bt-trx/dev-board/images/teensy_usb_cut.png

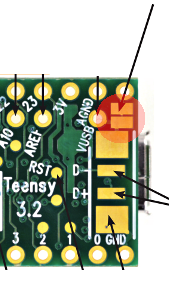
images/teensy_usb_cut.png
