bt-trx/dev-board/README.md

# bt-trx-dev-board

## BOM Generation

https://github.com/SchrodingersGat/KiBoM

### Installation

"Tools" -> "Generate Bill of Materials" -> New Plugin

### Benutzung

Eintragen der Bestellnummern ueber Properties des einzelnen Bauteils, oder gesammelt ueber "Tools"->"Edit Symbol Fields..."
