bt-trx/dev-board/images/3d_view.png

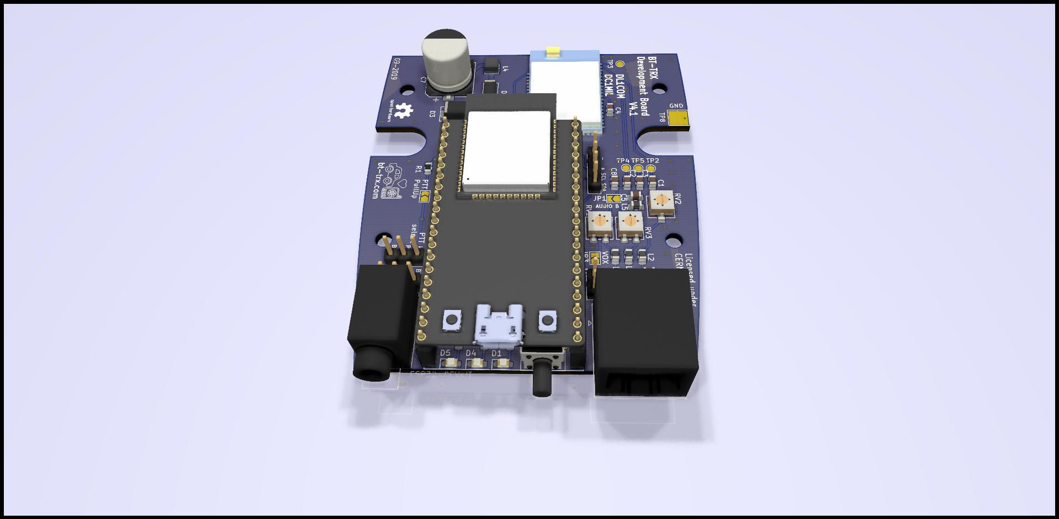
images/3d_view.png
