bt-trx/dev-board/3d_models/panasonic/EVQPU-LC-02K.STEP

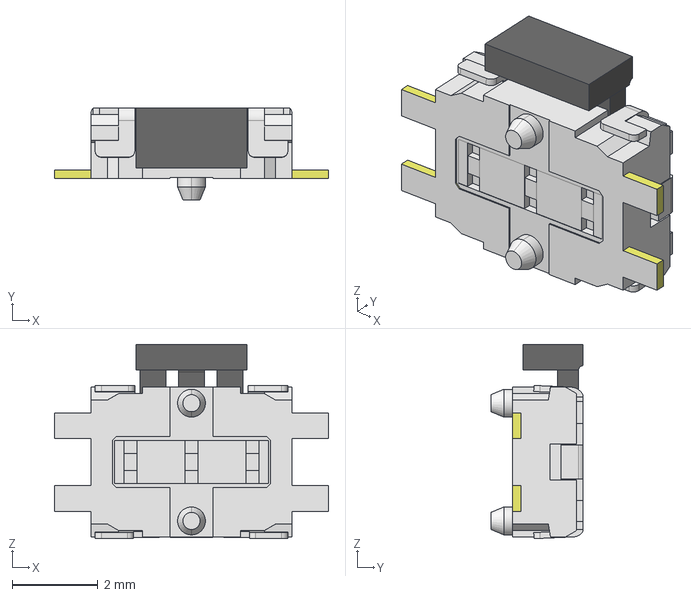
[picture p3: CAD file, 2019-08-11]
3d_models/panasonic/EVQPU-LC-02K.STEP
6.40 x 2.15 x 4.54 mm
