bt-trx/dev-board/3d_models/SJ1-3533NG/SJ1-3533NG.step

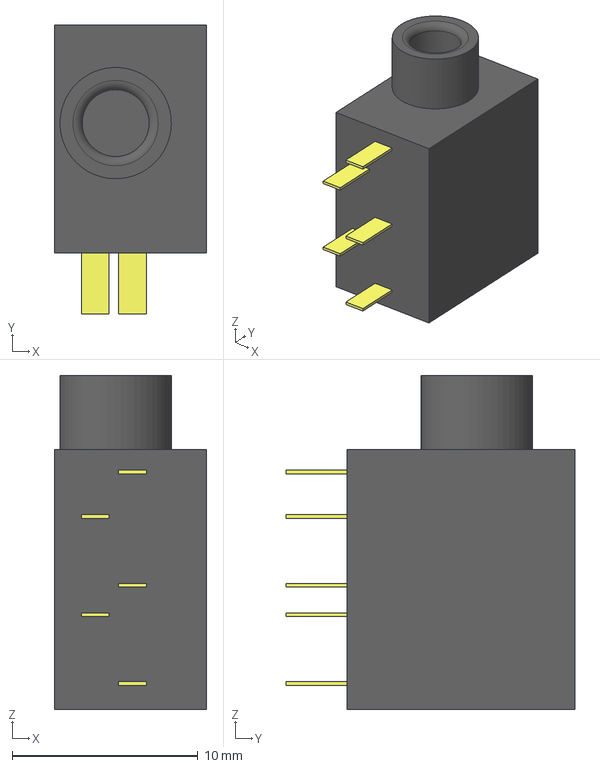
[picture p4: CAD file, 2019-08-11]
3d_models/SJ1-3533NG/SJ1-3533NG.step
8.20 x 15.6 x 18.0 mm
