bt-trx/dev-board/3d_models/54602-908LF/54602-908LF.step

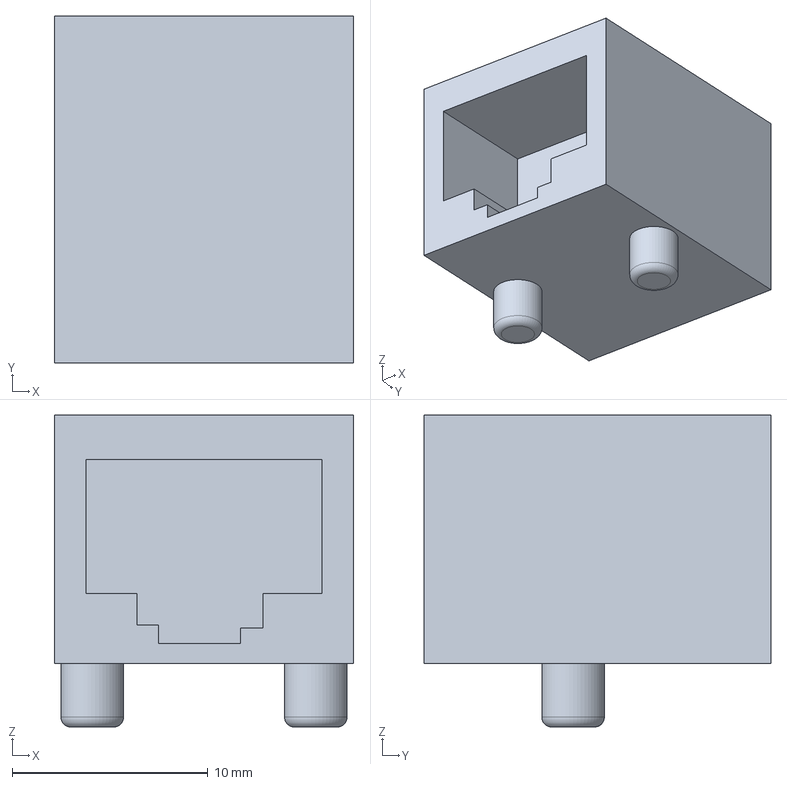
[picture p5: CAD file, 2019-08-11]
3d_models/54602-908LF/54602-908LF.step
15.3 x 17.7 x 16.0 mm
