bt-trx/dev-board/bt-trx-dev-board.kicad_pcb

## KiCad design bt-trx-dev-board.kicad_pcb (2020-01-25)

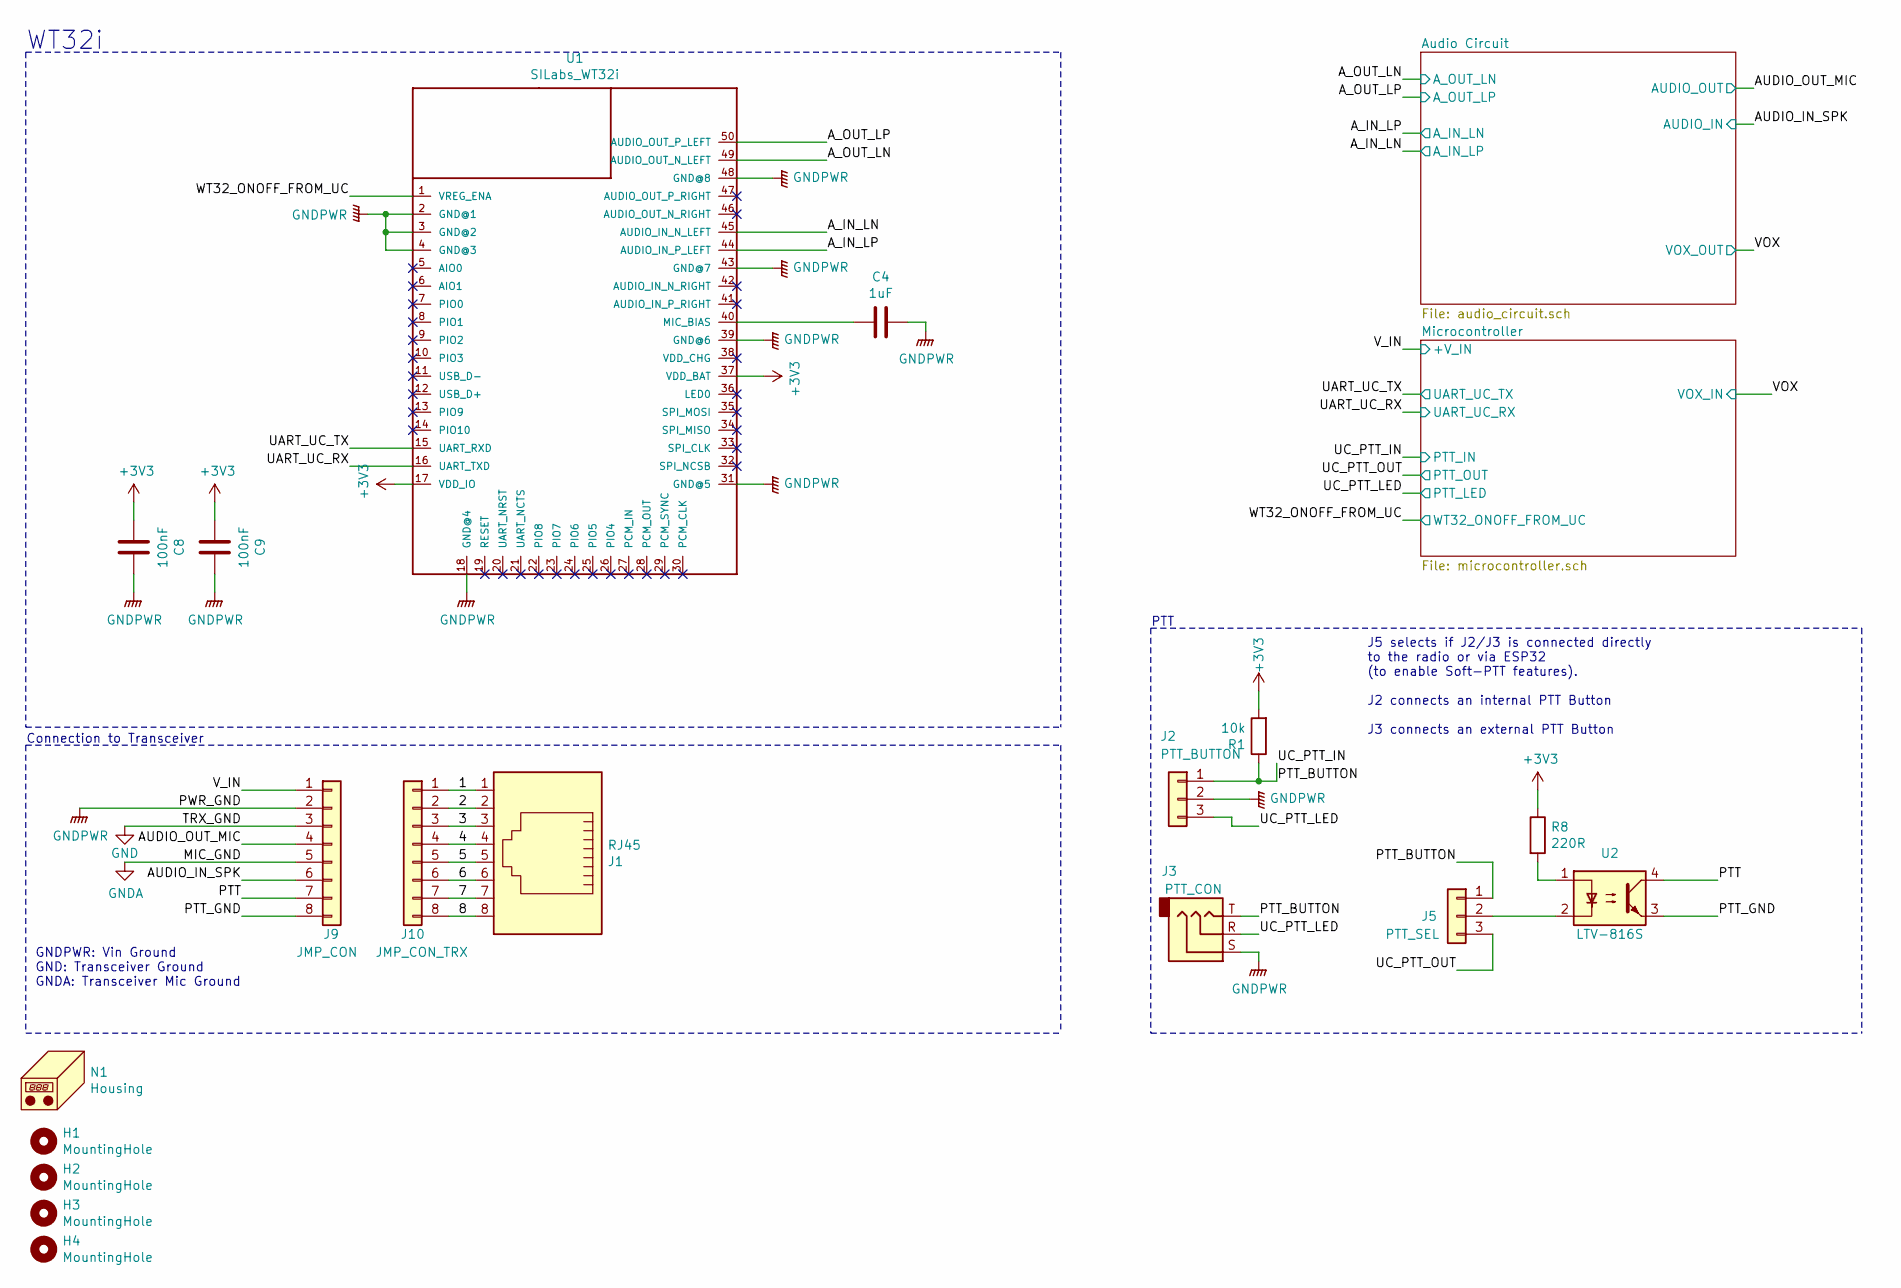
[picture p6: schematic bt-trx-dev-board.sch, BT-TRX Development Board]

Parts:
C4: 1uF; C_0805_2012Metric_Pad1.15x1.40mm_HandSolder; Mouser Best.Nr. 80-C0805C105K3RAUTO
C8, C9: 100nF; C_0805_2012Metric_Pad1.15x1.40mm_HandSolder; Mouser Best.Nr. 80-C0805C105K3RAUTO
H1, H2, H3, H4: MountingHole; MountingHole_3.2mm_M3_DIN965
J1: RJ45; RJ45_Amphenol_54602-x08_Horizontal; Mouser Best.Nr. 649-54602-908LF
J2: PTT_BUTTON; PinHeader_1x03_P2.54mm_Vertical; Mouser Best.Nr. 855-M20-9990346
J3: PTT_CON; Jack_3.5mm_CUI_SJ1-3533NG_Horizontal; Mouser Best.Nr. 490-SJ1-3533NG
J5: PTT_SEL; PinHeader_1x03_P2.54mm_Vertical; Mouser Best.Nr. 855-M20-9990346
J9: JMP_CON; PinSocket_1x08_P2.54mm_Vertical; Mouser Best.Nr. 855-M20-7820842
J10: JMP_CON_TRX; PinSocket_1x08_P2.54mm_Vertical; Mouser Best.Nr. 855-M20-7820842
N1: Housing; OSHW-Logo2_7.3x6mm_SilkScreen; Mouser Best.Nr. 546-1553CBKBAT
R1: 10k; R_0805_2012Metric_Pad1.15x1.40mm_HandSolder; Mouser Best.Nr. 603-RC0805FR-0710KL
R8: 220R; R_0805_2012Metric_Pad1.15x1.40mm_HandSolder; Mouser Best.Nr. 603-RC0805FR-0710KL
U1: SILabs_WT32i; LGA50-1.0-23.9X15.9MM; Mouser Best.Nr. 634-WT32I-A-AI61
U2: LTV-816S; Mouser Best.Nr. 859-LTV-816S

Connections:
+3V3: C8.2, C9.2, R1.2, R8.1, U1.17 (VDD_IO), U1.37 (VDD_BAT); also elsewhere on the board
/1: J1.1, J10.1
/2: J1.2, J10.2
/3: J1.3, J10.3
/4: J1.4, J10.4
/5: J1.5, J10.5
/6: J1.6, J10.6
/7: J1.7, J10.7
/8: J1.8, J10.8
/AUDIO_IN_SPK: J9.6; also elsewhere on the board
/AUDIO_OUT_MIC: J9.4; also elsewhere on the board
/A_IN_LN: U1.45 (AUDIO_IN_N_LEFT); also elsewhere on the board
/A_IN_LP: U1.44 (AUDIO_IN_P_LEFT); also elsewhere on the board
/A_OUT_LN: U1.49 (AUDIO_OUT_N_LEFT); also elsewhere on the board
/A_OUT_LP: U1.50 (AUDIO_OUT_P_LEFT); also elsewhere on the board
/PTT: J9.7, U2.4
/PTT_BUTTON: J2.1, J3.T, J5.1, R1.1; also elsewhere on the board
/PTT_GND: J9.8, U2.3
/UART_UC_RX: U1.16 (UART_TXD); also elsewhere on the board
/UART_UC_TX: U1.15 (UART_RXD); also elsewhere on the board
/UC_PTT_LED: J2.3, J3.R; also elsewhere on the board
/UC_PTT_OUT: J5.3; also elsewhere on the board
/V_IN: J9.1; also elsewhere on the board
/WT32_ONOFF_FROM_UC: U1.1 (VREG_ENA); also elsewhere on the board
GND: J9.3; also elsewhere on the board
GNDA: J9.5; also elsewhere on the board
GNDPWR: C4.1, C8.1, C9.1, J2.2, J3.S, J9.2, U1.2 (GND@1), U1.3 (GND@2), U1.4 (GND@3), U1.18 (GND@4), U1.31 (GND@5), U1.39 (GND@6), U1.43 (GND@7), U1.48 (GND@8); also elsewhere on the board
unnamed: C4.2, U1.40 (MIC_BIAS)
unnamed: J5.2, U2.2
unnamed: R8.2, U2.1

Notes on the sheet:
Connection to Transceiver
WT32i
PTT
J5 selects if J2/J3 is connected directly to the radio or via ESP32 (to enable Soft-PTT features). J2 connects an internal PTT Button J3 connects an external PTT Button
GNDPWR: Vin Ground GND: Transceiver Ground GNDA: Transceiver Mic Ground

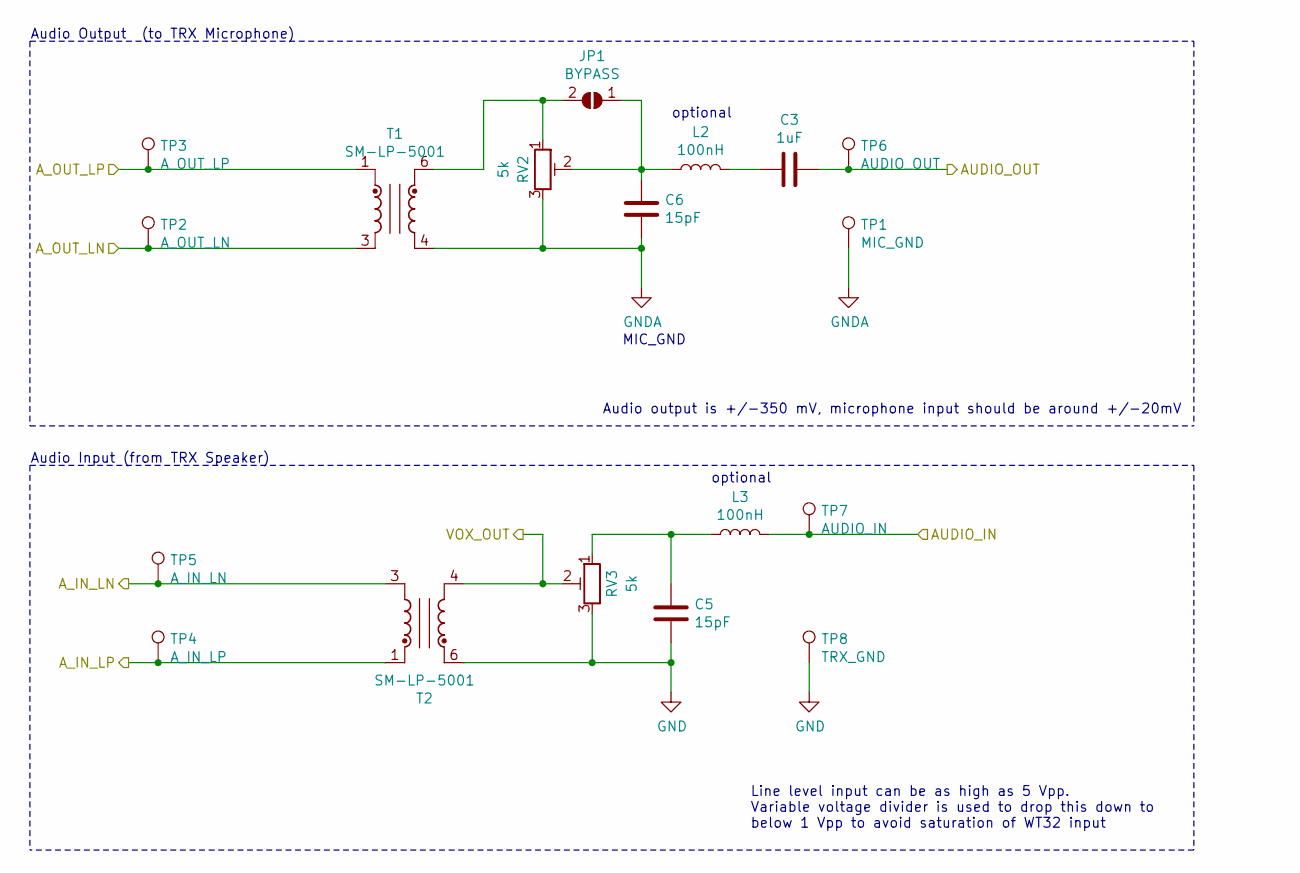
[picture p7: schematic audio_circuit.sch, BT-TRX Development Board]

Parts:
C3: 1uF; C_0805_2012Metric_Pad1.15x1.40mm_HandSolder; Mouser Best.Nr. 80-C0805C105K3RAUTO
C5, C6: 15pF; C_0805_2012Metric_Pad1.15x1.40mm_HandSolder; Mouser Best.Nr. 710-885012007011
JP1: BYPASS; SolderJumper-2_P1.3mm_Open_TrianglePad1.0x1.5mm
L2, L3: 100nH; L_0805_2012Metric_Pad1.15x1.40mm_HandSolder; Mouser Best.Nr. 810-MLF2012DR10MT000
RV2, RV3: 5k; Potentiometer_Vishay_TS53YL_Vertical; Mouser Best.Nr. 72-TS53YL-5K
T1, T2: SM-LP-5001; Mouser Best.Nr. 652-SM-LP-5001
TP1: MIC_GND; TestPoint_Pad_D1.5mm
TP2: A_OUT_LN; TestPoint_Pad_D1.5mm
TP3: A_OUT_LP; TestPoint_Pad_D1.5mm
TP4: A_IN_LP; TestPoint_Pad_D1.5mm
TP5: A_IN_LN; TestPoint_Pad_D1.5mm
TP6: AUDIO_OUT; TestPoint_Pad_D1.5mm
TP7: AUDIO_IN; TestPoint_Pad_D1.5mm
TP8: TRX_GND; TestPoint_Pad_4.0x4.0mm

Connections:
/AUDIO_IN_SPK: L3.2, TP7.1; also elsewhere on the board
/AUDIO_OUT_MIC: C3.1, TP6.1; also elsewhere on the board
/A_IN_LN: T2.1, TP4.1; also elsewhere on the board
/A_IN_LP: T2.3, TP5.1; also elsewhere on the board
/A_OUT_LN: T1.3, TP2.1; also elsewhere on the board
/A_OUT_LP: T1.1, TP3.1; also elsewhere on the board
/VOX: RV3.2, T2.4; also elsewhere on the board
GND: C5.2, RV3.3, T2.6, TP8.1; also elsewhere on the board
GNDA: C6.2, RV2.3, T1.4, TP1.1; also elsewhere on the board
unnamed: C3.2, L2.2
unnamed: C5.1, L3.1, RV3.1
unnamed: C6.1, JP1.1 (A), L2.1, RV2.2
unnamed: JP1.2 (B), RV2.1, T1.6

Notes on the sheet:
Line level input can be as high as 5 Vpp. Variable voltage divider is used to drop this down to below 1 Vpp to avoid saturation of WT32 input
Audio output is +/-350 mV, microphone input should be around +/-20mV
Audio Output (to TRX Microphone)
MIC_GND
optional
Audio Input (from TRX Speaker)

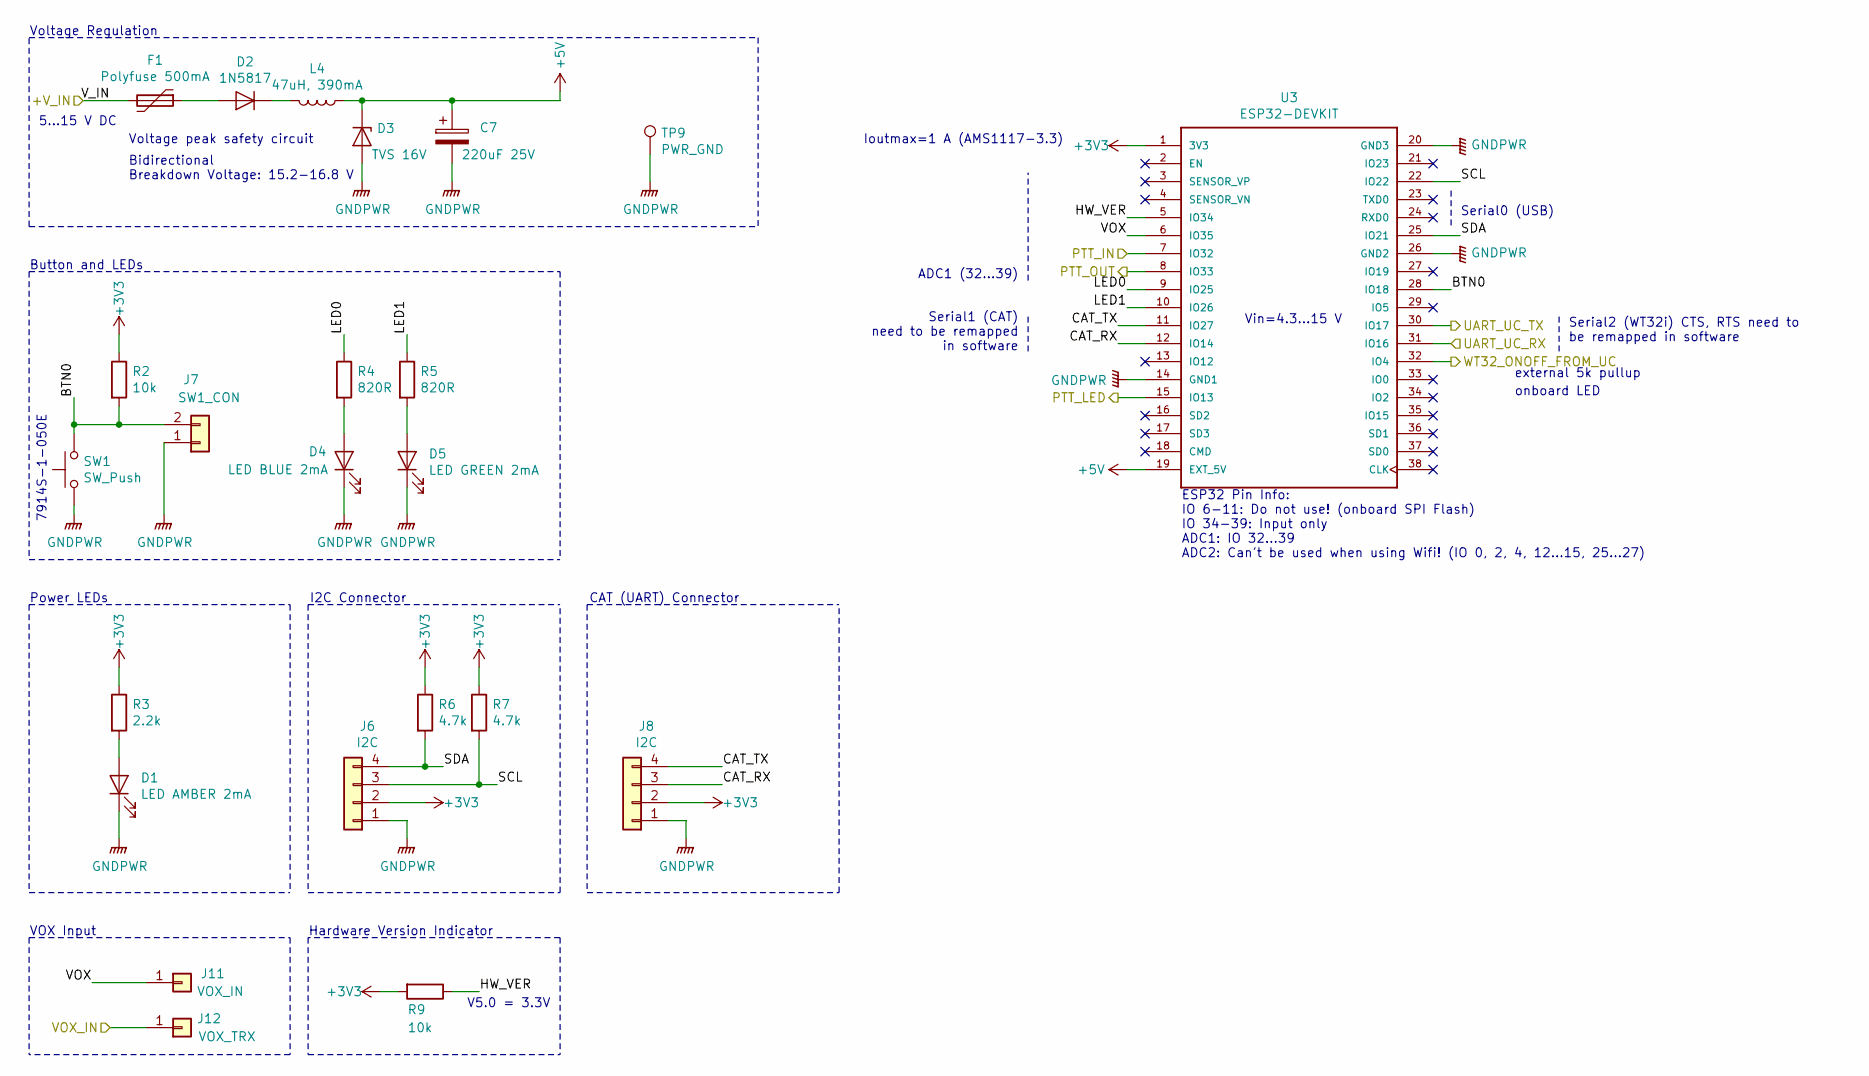
[picture p8: schematic microcontroller.sch, BT-TRX Development Board]

Parts:
C7: 220uF 25V; CP_Elec_10x10.5; Mouser Best.Nr. 667-EEE-HA1H221P
D1: LED AMBER 2mA; APA2107LSECK; Mouser Best.Nr. 604-APA2107LSECKJ4RV
D2: 1N5817; D_SMA; Mouser Best.Nr. 583-FM5817
D3: TVS 16V; D_SMB; Mouser Best.Nr. 652-P6SMB16CA
D4: LED BLUE 2mA; APA2107LSECK; Mouser Best.Nr. 604-APA2107LVBCD
D5: LED GREEN 2mA; APA2107LSECK; Mouser Best.Nr. 604-APA2107LZGCK
F1: Polyfuse 500mA; Fuse_1206_3216Metric_Pad1.42x1.75mm_HandSolder; Mouser Best.Nr. 530-0ZCJ0025AF2E
J6, J8: I2C; PinHeader_1x04_P2.54mm_Vertical; Mouser Best.Nr. 855-M20-9770446
J7: SW1_CON; PinHeader_1x02_P2.54mm_Vertical; Mouser Best.Nr. 855-M20-9990246
J11: VOX_IN; PinSocket_1x01_P2.54mm_Vertical
J12: VOX_TRX; PinSocket_1x01_P2.54mm_Vertical
L4: 47uH, 390mA; L_Wuerth_MAPI-3020; Mouser Best.Nr. 710-74438335470
R2, R9: 10k; R_0805_2012Metric_Pad1.15x1.40mm_HandSolder; Mouser Best.Nr. 603-RC0805FR-0710KL
R3: 2.2k; R_0805_2012Metric_Pad1.15x1.40mm_HandSolder; Mouser Best.Nr. 603-RC0805JR-072K2L
R4, R5: 820R; R_0805_2012Metric_Pad1.15x1.40mm_HandSolder; Mouser Best.Nr. 603-RC0805JR-07820RL
R6, R7: 4.7k; R_0805_2012Metric_Pad1.15x1.40mm_HandSolder; Mouser Best.Nr. 603-RC0805JR-074K7L
SW1: SW_Push; SW_Tactile_SKHH_Angled; Mouser Best.Nr. 611-PTS645VK832
TP9: PWR_GND; TestPoint_Pad_4.0x4.0mm
U3: ESP32-DEVKIT; ESP32-DEVKITC-32D; Mouser Best.Nr. 356-ESP32-DEVKITC32D

Connections:
+3V3: J6.2, J8.2, R2.1, R3.1, R6.1, R7.1, R9.2, U3.1 (3V3); also elsewhere on the board
+5V: C7.1, D3.1 (K), L4.1, U3.19 (EXT_5V)
/Microcontroller/BTN0: J7.2, R2.2, SW1.2, U3.28 (IO18)
/Microcontroller/CAT_RX: J8.3, U3.12 (IO14)
/Microcontroller/CAT_TX: J8.4, U3.11 (IO27)
/Microcontroller/HW_VER: R9.1, U3.5 (IO34)
/Microcontroller/LED0: R4.1, U3.9 (IO25)
/Microcontroller/LED1: R5.1, U3.10 (IO26)
/Microcontroller/SCL: J6.3, R7.2, U3.22 (IO22)
/Microcontroller/SDA: J6.4, R6.2, U3.25 (IO21)
/Microcontroller/VOX: J11.1, U3.6 (IO35)
/PTT_BUTTON: U3.7 (IO32); also elsewhere on the board
/UART_UC_RX: U3.31 (IO16); also elsewhere on the board
/UART_UC_TX: U3.30 (IO17); also elsewhere on the board
/UC_PTT_LED: U3.15 (IO13); also elsewhere on the board
/UC_PTT_OUT: U3.8 (IO33); also elsewhere on the board
/VOX: J12.1; also elsewhere on the board
/V_IN: F1.2; also elsewhere on the board
/WT32_ONOFF_FROM_UC: U3.32 (IO4); also elsewhere on the board
GNDPWR: C7.2, D1.1 (K), D3.2 (A), D4.1 (K), D5.1 (K), J6.1, J7.1, J8.1, SW1.1, TP9.1, U3.14 (GND1), U3.20 (GND3), U3.26 (GND2); also elsewhere on the board
unnamed: D1.2 (A), R3.2
unnamed: D2.1 (K), L4.2
unnamed: D2.2 (A), F1.1
unnamed: D4.2 (A), R4.2
unnamed: D5.2 (A), R5.2

Notes on the sheet:
Button and LEDs
Voltage peak safety circuit
Power LEDs
5...15 V DC
7914S-1-050E
I2C Connector
Bidirectional Breakdown Voltage: 15.2-16.8 V
CAT (UART) Connector
VOX Input
Hardware Version Indicator
V5.0 = 3.3V
Voltage Regulation
ADC1 (32...39)
Serial1 (CAT) need to be remapped in software
external 5k pullup
onboard LED
Vin=4.3...15 V
Serial0 (USB)
ESP32 Pin Info: IO 6-11: Do not use! (onboard SPI Flash) IO 34-39: Input only ADC1: IO 32...39 ADC2: Can't be used when using Wifi! (IO 0, 2, 4, 12...15, 25...27)
Serial2 (WT32i) CTS, RTS need to be remapped in software
Ioutmax=1 A (AMS1117-3.3)

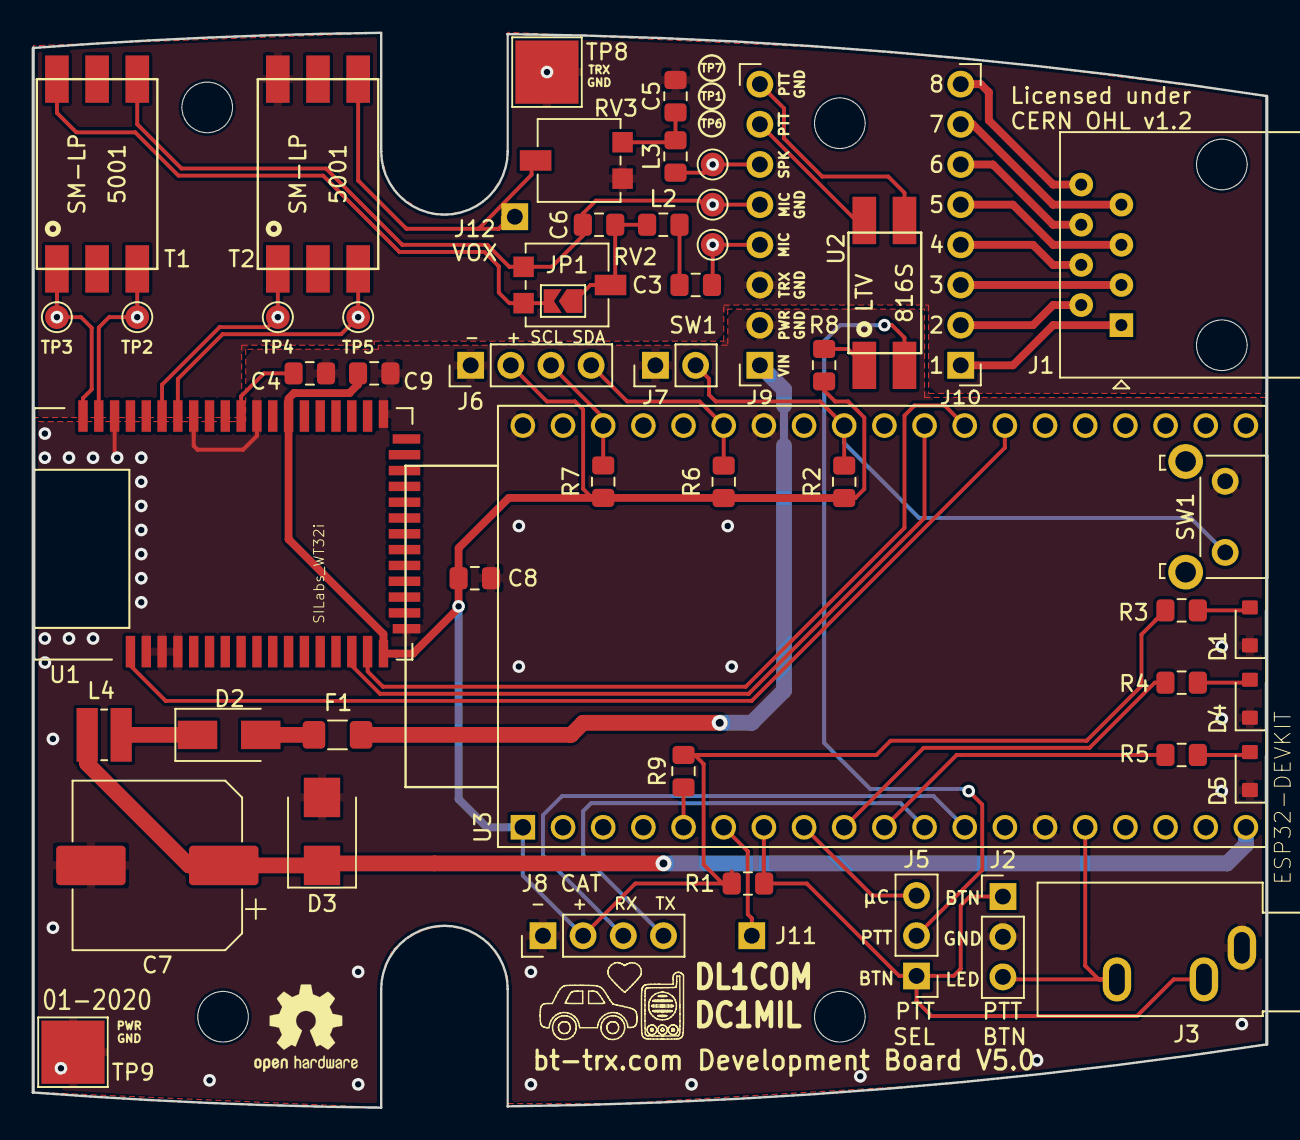
[picture p9: board bt-trx-dev-board.kicad_pcb from above]

Board: 2 copper layers, 78.0 x 68.0 mm, 59 parts (0 on the bottom side), 50 nets.
