bt-trx/dev-board/(threads)

Thread 1 (2019-07-24):

Replace Teensy with ESP32

andz82, 2019-07-24:

Closed 2019-08-08.

Thread 4 (2019-08-07):

Review v4 PCB

andz82, 2019-08-07:

chris007de, 2019-08-11:
* RJ45 +1.0 mm to the right
* PTT +1.0 mm to the right
* Added footprint for ESP-32 NodeMCU Board to lib/nodemcu_esp-32s/nodemcu_esp-32s.pretty
Please change the footprint library path in Pcbnew to this folder and substitute the old footprint.

Closed 2019-09-14.

Thread 6 (2019-08-08):

Create 3D rendering

andz82, 2019-08-08:

andz82, 2019-08-11:
ESP32 and button missing

Closed 2019-08-13.

Thread 7 (2019-09-14):

Connect Ring contact of J3 to a GPIO pin

chris007de, 2019-09-14:
To be able to indicate the current PTT state, a GPIO pin shall be connected to the Ring contact of the 3.5mm jack (J3).
The users can add a LED to their external PTT buttons, which will light up while PTT is pressed or latched (by software).

andz82, 2019-09-27:
Needed to move PTT_IN from GPIO32 to GPIO35

Closed 2019-09-27.

Thread 8 (2019-09-14):

Add solder contacts for external connection of button SW1

chris007de, 2019-09-14:
To enable the users to attach an external button instead of SW1, the BTN0 signal (and GND) shall be exposed as solder contacts.

Closed 2019-09-27.

Thread 12 (2019-09-22):

Change footprint of ESP32 to devkitc

chris007de, 2019-09-22:
Due to a change of supplier, the ESP32 module's footprint has changed.
Please use the ESP32 devkitc footprint (https://github.com/bt-trx/dev-board/blob/master/lib/nodemcu_esp-32s/nodemcu_esp-32s.pretty/ESP32-DEVKITC-32D.mod) and re-align the edge of the module with the edge of the bt-trx board.

Closed 2019-09-27.

Thread 15 (2019-09-29):

Replace PTT Pullup Jumper with solder jumper

andz82, 2019-09-29:

Closed 2019-10-05.

Thread 18 (2019-10-05):

Check if usage of old model for SW1 (from dev-board v3)

chris007de, 2019-10-05:
As the ESP32 shall be mounted with plug headers, there should be enough room between the dev-board PCB and the ESP32 module PCB to revert to the usage of the old switch.

Closed 2019-10-06.

Thread 19 (2019-10-20):

Fix position of rear mounting holes

chris007de, 2019-10-20:
Currently (v4.1), the rear mounting holes are not perfectly aligned with the actual position of the screw holes in the Hammond 1553 enclosure.

Closed 2020-01-20.

Thread 20 (2019-11-04):

Fix number ordering of J1 in the schematic.

chris007de, 2019-11-04:
The symbol of J1 shows the pins in the reverse order than they actually are.

Fix by mirror the symbol vertically, 180° rotation and reconnecting the signals.

Closed 2019-11-04.

Thread 21 (2019-12-03):

New features for dev-board 5.0

andz82, 2019-12-03:
- [x]  Rework Audio
  - [x] Separate AGND from DGND/PWRGND as good as possible
  - [x] Reorder RJ-45 pin assignment to make use of twisted-pair wiring
  - [x] Check if differential to single ended for audio-out can be solved better
  - [x] Remove AGND-plane from bottom-side
  - [x] Remove Audio-B (#23)
  - [ ] ~~Prototype VOX~~
  - [x] Reduce number of trimmers if possible
- [x] Add VIAs on test points for better alignment
- [x] Rework PTT with opto-coupler (#22)
- [ ] ~~Reevaluate form factor of PCB~~
- [ ] ~~Set Soft-PTT to default (with solder-jumper?)~~
- [x] Check usage of jumpers for configuring the assignment of the RJ45 pins (which would eliminate the need for a custom cable in some case), see RemoteRig

Closed 2020-01-20.

Thread 25 (2020-01-20):

Rewiew PCB V5.0

andz82, 2020-01-20:

chris007de, 2020-01-21:
- [ ] Proposal from Xaver: Add kerko in Vin path. Why yes/no?
- [ ] Add Pullup (10k) for Hardware version indicator
- [ ] gnda groundplane shall end at the transformers, currently it's also under the diff signals of wt32, which is pwrgnd domain.

andz82, 2020-01-21:
**Proposal from Xaver: Add kerko in Vin path. Why yes/no?**
C1 on ESP32 DevKit C (10uF) should be fine

Closed 2020-01-22.

Thread 30 (2021-11-02):

Suboptimal placement of D3 suppressor diode

dg1yfe, 2021-11-02:
At the current position (connected to the node L4/C7/+5V), the suppressor diode D3 cannot work properly as a peak suppressor: The capacitor does not allow for voltage spikes and will absorb as much current as it can (limited only by ESR). Therefore D3 will be unable to absorb those spikes properly.
A much better position would be at the node between D2 and L4 : Here it is decoupled from C7 by L4 and may "absorb" short voltage spikes properly.

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

Closed 2023-03-28.
