bt-trx/dev-board/(commit log)

2019-06-21 Squash commit of private dev repo for publication
    [54602-908LF.step, SJ1-3533NG.step, audio_cirquit.sch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]
2019-07-04 renamed audio_cirquit.sch to audio_circuit.sch
    [audio_circuit.sch, bt-trx-dev-board.sch]
2019-07-04 Add ESP-32S symbol and footprint, start integration
    [microcontroller.sch]
2019-07-24 Assigned Pins to ESP32 and removed Teensy [#1]
    [audio_circuit.sch, bt-trx-dev-board.sch, microcontroller.sch]
2019-07-24 Continued v4 [#1]
    *removed all v3 stuff
    * Resized board to max case size
    * First deratsnesting
    [bt-trx-dev-board.kicad_pcb, bt-trx-dev-board.sch, microcontroller.sch]
2019-08-06 [#1] Refined Schematic
    * Removed RTS CTS
    * Added 15pF capacitator to audio IN+
    * Removed PTT jumper
    * Added pull-up jumper
    * Added solder jmpr bypass to RV
    * Changed button footprint to SMD version
    [audio_circuit.sch, bt-trx-dev-board.kicad_pcb, bt-trx-dev-board.sch, microcontroller.sch]
2019-08-06 [#1] Reworked audio path
    * Swaped LN and LP for better reading
    * Rearanged audio-in cirquid
    [audio_circuit.sch, microcontroller.sch]
2019-08-06 [#1] Deratsnested PCB
    [bt-trx-dev-board.kicad_pcb]
2019-08-06 [#1] Continued PCB
    * Moved button pin for better tracability
    * Added all missing traces
    [bt-trx-dev-board.kicad_pcb, microcontroller.sch]
2019-08-08 [#2] Beatufied PCB
    * Put all silkscreen items on the right place
    * Added keepout to BT antenna
    * Added couple of vias for better grounding
    [bt-trx-dev-board.kicad_pcb]
2019-08-08 [#6] Added 3D Models
    [bt-trx-dev-board.kicad_pcb]
2019-08-11 [#2] Add ESP32-NodeMCU Footprint
2019-08-11 [#2] Update Schematic with new Footprint for ESP32 Board
    [audio_circuit.sch, bt-trx-dev-board.sch, microcontroller.sch]
2019-08-11 Fix some comments
    [audio_circuit.sch, bt-trx-dev-board.sch, microcontroller.sch]
2019-08-11 [#4] Replaced wrong ESP32 package
    [bt-trx-dev-board.kicad_pcb]
2019-08-11 [#4] Fixed typo in version number on pcb
    [bt-trx-dev-board.kicad_pcb]
2019-08-11 [#3] Added new version number to sheets
    [audio_circuit.sch, bt-trx-dev-board.sch, microcontroller.sch]
2019-08-11 [#2] Moved silkscreen away from screw
    [bt-trx-dev-board.kicad_pcb]
2019-08-11 [#] Repacled 3D models
    * RJ45
    * Audio jack
    [bt-trx-dev-board.kicad_pcb]
2019-08-11 [#6] Add 3D model for ESP32 board
    [bt-trx-dev-board.kicad_pcb]
2019-08-11 [#6] Colored custom step models
    [54602-908LF.step, SJ1-3533NG.step]
2019-08-11 [#2] Added 3d Model for Push Button
    [EVQPU-LC-02K.STEP, bt-trx-dev-board.kicad_pcb]
2019-08-11 [2#] Replaced ESP 3D Model in PCB
    [bt-trx-dev-board.kicad_pcb]
2019-08-11 [#6] Put some color on button stepfile
    [EVQPU-LC-02K.STEP]
2019-08-12 [#3][#4] Moved CAT pins
    Moved CAT TX and RX from pin 12/13 to pin 11/12 due to
    bootup problems with pin 13.
    [bt-trx-dev-board.kicad_pcb, microcontroller.sch]
2019-08-13 [#5] Added Missing Parts to BOM
    * Replaced audio Cs with ceramic
    * Changed audio output DC block C to 1uF
    * Added ESP32 to BOM
    [audio_circuit.sch, microcontroller.sch]
2019-08-13 [#3] Removed unnecessary Text
    [audio_circuit.sch]
2019-08-13 Generated gerber-files for order
    [bt-trx-dev-board-B.Cu.gbl, bt-trx-dev-board-B.Mask.gbs, bt-trx-dev-board-B_Cu.gbl, bt-trx-dev-board-B_Mask.gbs, bt-trx-dev-board-B_SilkS.gbo, bt-trx-dev-board-Edge.Cuts.gm1, bt-trx-dev-board-Edge_Cuts.gm1, bt-trx-dev-board-F.Cu.gtl]
2019-08-13 Added BOM
    [bt-trx-dev-board.csv]
2019-09-27 [#7] Connected Ring of J3 to GPIO32
    * Warning: Needed to move PTT_IN from GPIO32 to GPIO35
    [audio_circuit.sch, bt-trx-dev-board.sch, microcontroller.sch]
2019-09-27 [#8] Added solder contacts for external Button SW1
    [microcontroller.sch]
2019-09-27 [#9] Remove D6
    [microcontroller.sch]
2019-09-27 [#10] Move F1 to V_IN
    [microcontroller.sch]
2019-09-27 [#12] Change footprint of ESP32 to devkitc
    * Converted mod file to kicat_mod
    * Replaced Footprint in schematic
    [microcontroller.sch]
2019-09-27 [#13] Add Hardware Version Indicator
    Pull GPIO34 to GND to indicate v4.1
    [microcontroller.sch]
2019-09-27 [#7][#8][#9][#10][#12][#13] Created PCB V4.1
    * Change footprint to DevKitC
    * Connect Ring contact of J3 to a GPIO
    * Add solder connector for SW1
    * Remove D6
    * Move F1 to VIN
    * Add Hardware Version Indicator
    * Added 3D Model for DevKitC
    [bt-trx-dev-board.kicad_pcb, microcontroller.sch]
2019-09-27 [#11] Connected Audio to ESP Pin
    * Connected Audio Input to GPIO15 in schematic and PCB
    * Added Solder Jumper
    [audio_circuit.sch, bt-trx-dev-board.kicad_pcb, bt-trx-dev-board.sch, microcontroller.sch]
2019-09-27 Changed Version and Date on Sheets
    [audio_circuit.sch, bt-trx-dev-board.kicad_pcb, bt-trx-dev-board.sch, microcontroller.sch]
2019-09-27 Changed Silkscreen a bit
    [bt-trx-dev-board.kicad_pcb]
2019-09-28 Adding annotations for ADC1/2
    [microcontroller.sch]
2019-09-29 [#15] Replaced PTT Pullup Jumper wit Solder Jumper
    [bt-trx-dev-board.kicad_pcb, bt-trx-dev-board.sch, microcontroller.sch]
2019-09-29 [#16] Move SW1 and VOX to usable Pins
    * Moved SW1 form GPIO0 to GPIO18
    * Added Pullup to SW1
    * Moved VOX form GPIO2 to GPIO35
    [bt-trx-dev-board.kicad_pcb, microcontroller.sch]
2019-10-06 [#17] Add PTT_LED to J2 and move J2 near/behind J3
    [bt-trx-dev-board.kicad_pcb, bt-trx-dev-board.sch]
2019-10-06 [#18] Changed SW1 from SMD to TH
    [bt-trx-dev-board.kicad_pcb, bt-trx-dev-board.sch, microcontroller.sch]
2019-10-06 Created BOM
    [bt-trx-dev-board.csv]
2019-10-06 Changed BOM due to availability
    [audio_circuit.sch, bt-trx-dev-board.csv]
2019-10-06 Generated Gerber files
    [bt-trx-dev-board-B_Cu.gbl, bt-trx-dev-board-B_Mask.gbs, bt-trx-dev-board-B_SilkS.gbo, bt-trx-dev-board-Edge_Cuts.gm1, bt-trx-dev-board-F_Cu.gtl, bt-trx-dev-board-F_Mask.gts, bt-trx-dev-board-F_Paste.gtp, bt-trx-dev-board-F_SilkS.gto]
2019-10-06 Replaced ESP32 DevKitC in BOM
    [bt-trx-dev-board.csv, microcontroller.sch]
2019-11-04 [#20] Fix orientation of J1 symbol in schematic
    [bt-trx-dev-board.sch]
2020-01-04 [#22] Insert Optocoupler for PTT
    [audio_circuit.sch, bt-trx-dev-board.sch, microcontroller.sch]
2020-01-04 [#23] Remove AUDIO_IN_B
    [audio_circuit.sch, bt-trx-dev-board.sch]
2020-01-15 Audio Rework in Schematic [#21]
    [audio_circuit.sch, bt-trx-dev-board.sch, microcontroller.sch]
2020-01-15 Further Audio Rework, separation of AGND and MIC_GND [#21]
    [audio_circuit.sch, bt-trx-dev-board.sch, microcontroller.sch]
2020-01-16 Continued Schematic for V5.0
    * Rearanged RJ45 connector
    * Added jumper wire connector
    * Renamed GNDs
    [audio_circuit.sch, bt-trx-dev-board.sch, microcontroller.sch]
2020-01-16 Added Footprints [#21]
    * Footprint LTV-816S
    * Footprint SML-P-5001
    [audio_circuit.sch]
2020-01-16 Replaced PTT-SEL with solder jumper [#21]
    * Replaced PTT-SEL with solder jumper
    * Fixed typos in comments
    [audio_circuit.sch, bt-trx-dev-board.sch]
2020-01-16 Fixed Typos and Missing Footprints [#21]
    [bt-trx-dev-board.sch]
2020-01-18 Fixed wrong footprint C1 [#21]
    [audio_circuit.sch]
2020-01-19 Continued V5.0 Schematic Rework [#21]
    - Replaced PTT_SEL Jumper from solder to pinheader
    - Added blockin capacitors to WT32i
    - Removed J9/10 solder jumpers
    - Added separate PTT GND
    - Changed hardware version indicator to 3.3V
    [audio_circuit.sch, bt-trx-dev-board.sch, microcontroller.sch]
2020-01-20 Reworked PCB [#19][#21][#22][#23]
    * Reworked PCB with new v5.0 schematic
    * Fixed position of mounting holes
    [audio_circuit.sch, bt-trx-dev-board.kicad_pcb, bt-trx-dev-board.sch, microcontroller.sch]
2020-01-20 Add VIAs on test points for better alignment [#21]
    [bt-trx-dev-board.kicad_pcb]
2020-01-20 Minor changes in silkscreen [#21]
    [bt-trx-dev-board.kicad_pcb, microcontroller.sch]
2020-01-21 Added Pullup to HW indicator [#25]
    [bt-trx-dev-board.kicad_pcb, microcontroller.sch]
2020-01-21 Flipped T2 for better grounding [#25]
    * Flipped input ports of T2 as there as no direct TRX-GND path from RV3 to T2
    [audio_circuit.sch, bt-trx-dev-board.kicad_pcb]
2020-01-21 Updated libraries for bourns and liteon
    * Added marking for pin 1
    * Added 3D Model
    [bt-trx-dev-board.kicad_pcb]
2020-01-22 PCB enhancements [#25]
    * Removed C1 and C2
    * Modified symmetric audio path
    * Modified VOX path
    [audio_circuit.sch, bt-trx-dev-board.kicad_pcb, microcontroller.sch]
2020-01-22 BOM Update
    [audio_circuit.sch, bt-trx-dev-board.csv, bt-trx-dev-board.sch, microcontroller.sch]
2020-01-22 Generated Gerber [#28]
    [bt-trx-dev-board-B_Cu.gbl, bt-trx-dev-board-B_Mask.gbs, bt-trx-dev-board-B_SilkS.gbo, bt-trx-dev-board-Edge_Cuts.gm1, bt-trx-dev-board-F_Cu.gtl, bt-trx-dev-board-F_Mask.gts, bt-trx-dev-board-F_Paste.gtp, bt-trx-dev-board-F_SilkS.gto]
2020-01-22 removed RV2 from order list
    [audio_circuit.sch]
2020-01-25 Silkscreen optimization
    * Added pin description to J9 and J10
    * Optimized some Silkscreen positions
    [bt-trx-dev-board.kicad_pcb]
2020-01-25 Updated release note
    [bt-trx-dev-board.kicad_pcb]
2020-01-29 Fixed mouser order IDs
    [audio_circuit.sch, bt-trx-dev-board.sch, microcontroller.sch]
2020-01-29 Re-plotted gerber files for production
    [bt-trx-dev-board-B_Cu.gbl, bt-trx-dev-board-B_Mask.gbs, bt-trx-dev-board-B_SilkS.gbo, bt-trx-dev-board-Edge_Cuts.gm1, bt-trx-dev-board-F_Cu.gtl, bt-trx-dev-board-F_Mask.gts, bt-trx-dev-board-F_Paste.gtp, bt-trx-dev-board-F_SilkS.gto]
2020-03-03 Fixed wrong Parts in BOM (R8, C8, C9)
    [bt-trx-dev-board.csv]
2020-03-03 Add Digikey Part Numbers
    [audio_circuit.sch, bt-trx-dev-board.sch, microcontroller.sch]
2020-03-03 Remove Reichelt Part Nrs from BOM Export
2020-03-03 Update BOM Export
    [bt-trx-dev-board.csv]
