bt-trx/dev-board/(notices)

Notices in the files:
bt-trx-dev-board.kicad_pcb:
Licensed under
CERN OHL v1.2
microcontroller.sch:
Licensed under CERN OHL v1.2 - https://ohwr.org/licenses/cern-ohl/v1.2
